Electrium-Mobility/RC-W25/README.md

# RC-W25
Electrium Mobility W25 Remote Control Project
