Electrium-Mobility/RC-W25/remote/RC-W25.kicad_pcb

## KiCad design remote/RC-W25.kicad_pcb (2025-04-18)

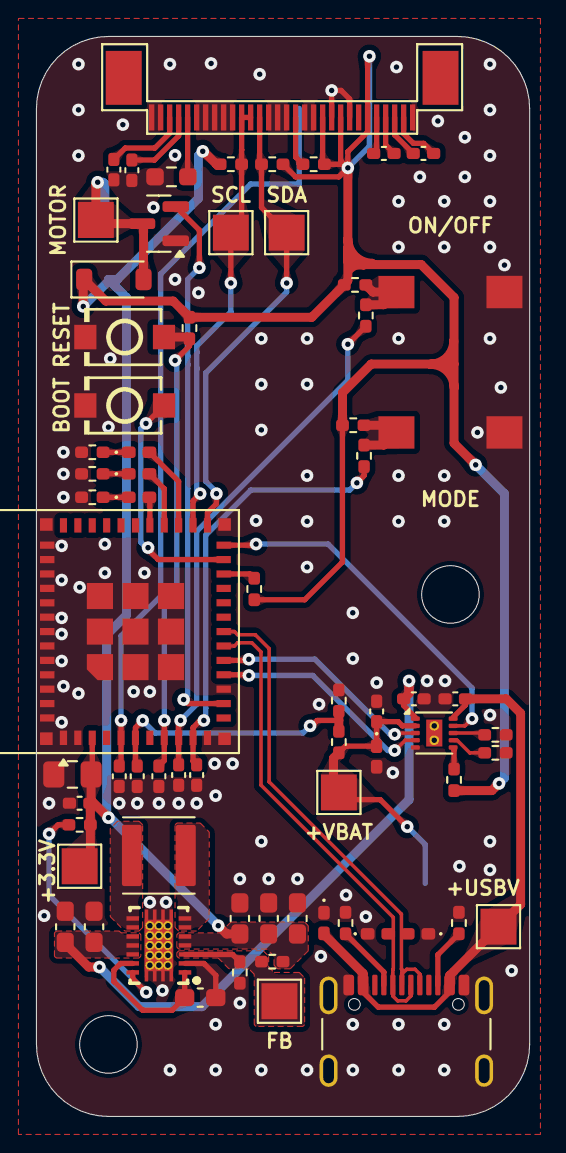
[picture p1: board RC-W25.kicad_pcb from above]

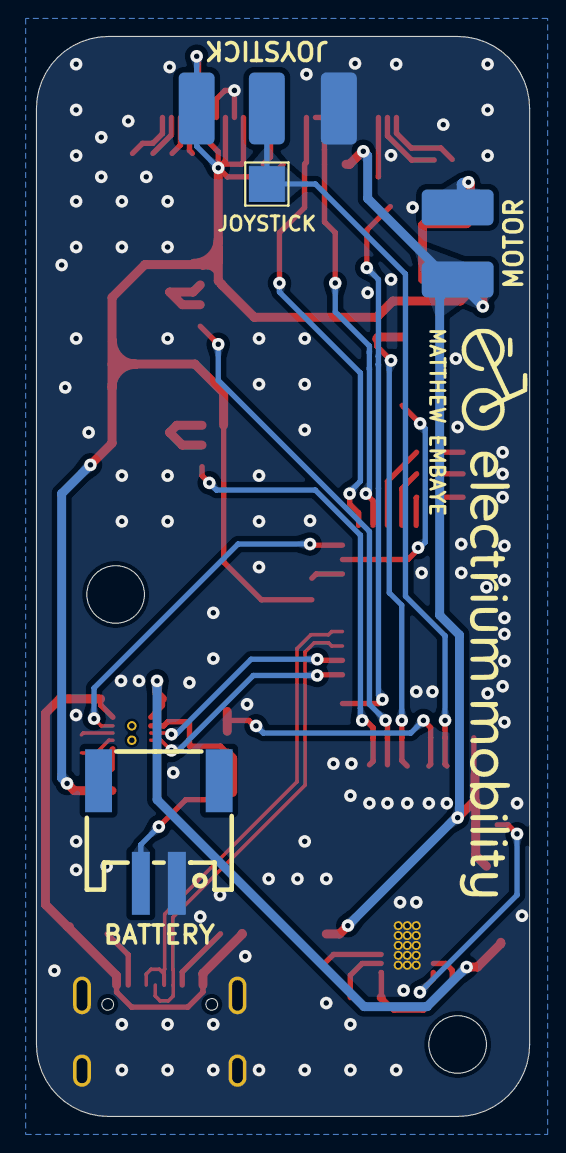
[picture p2: board RC-W25.kicad_pcb from below]

Board: 2 copper layers, 27.4 x 60.0 mm, 75 parts (4 on the bottom side), 47 nets.

Parts:
+3.3V: TEST POINT; TestPoint_Pad_2.0x2.0mm
+USBV: TEST POINT; TestPoint_Pad_2.0x2.0mm
+VBAT: TEST POINT; TestPoint_Pad_2.0x2.0mm
BATTERY: JST CONN; CONN-SMD_2P-P2.00_XUNPU_WAFER-PH2.0-2PWB
BOOT: Button; SW-SMD_L3.9-W3.0-P4.45
C1, C10: 4.7uF; C_0402_1005Metric_Pad0.74x0.62mm_HandSolder
C2, C18: 10uF; C_0402_1005Metric_Pad0.74x0.62mm_HandSolder
C3, C4: 2.2uF; C_0402_1005Metric_Pad0.74x0.62mm_HandSolder
C5, C6, C7, C9, C19, C20: 100nF; C_0402_1005Metric_Pad0.74x0.62mm_HandSolder
C8: 22uF; C_0805_2012Metric_Pad1.18x1.45mm_HandSolder
C11, C12: 10uF; C_0603_1608Metric_Pad1.08x0.95mm_HandSolder
C13: 100nF; C_0603_1608Metric_Pad1.08x0.95mm_HandSolder
C14: 1uF; C_0402_1005Metric_Pad0.74x0.62mm_HandSolder
C15, C16, C17: 22uF; C_0603_1608Metric_Pad1.08x0.95mm_HandSolder
D1, D2, D3: 6V TVS; D_0402_1005Metric_Pad0.77x0.64mm_HandSolder
D4: RLED; D_0402_1005Metric_Pad0.77x0.64mm_HandSolder
D5: ORLED; D_0402_1005Metric_Pad0.77x0.64mm_HandSolder
D6: GLED; D_0402_1005Metric_Pad0.77x0.64mm_HandSolder
D7: ZENER 5V; D_0402_1005Metric_Pad0.77x0.64mm_HandSolder
D8: D_Schottky; D_SOD-123
DS1: FPC 30P; FPC-30P-0.5mm
FB: TEST POINT; TestPoint_Pad_2.0x2.0mm
H1, H2: MountingHole; MountingHole_3.2mm_M3
J1: USB_C_Receptacle_USB2.0_14P; USB_C_Receptacle_GCT_USB4105-xx-A_16P_TopMnt_Horizontal
JOYSTICK: TEST POINT; TestPoint_Pad_2.0x2.0mm
JOYSTICK#2: JOYSTICK; Joystick Potentiometer Pads
L1: 1.5uH; L_Abracon_ASPI-4030S
MODE: Button; Box Tactile Button Switch
MOTOR: TEST POINT; TestPoint_Pad_2.0x2.0mm
MOTOR#2: MOTOR; Motor Pads
ON/OFF: Button; Box Tactile Button Switch
Q1: NMOS; SOT-23
R1: 390k; R_0603_1608Metric_Pad0.98x0.95mm_HandSolder
R2, R3, R4: 4.7k; R_0402_1005Metric_Pad0.72x0.64mm_HandSolder
R5, R6: 5.1k; R_0402_1005Metric_Pad0.72x0.64mm_HandSolder
R7, R8, R20, R21, R22, R23: 10k; R_0402_1005Metric_Pad0.72x0.64mm_HandSolder
R9, R10, R11: 300; R_0402_1005Metric_Pad0.72x0.64mm_HandSolder
R12: 5k; R_0402_1005Metric_Pad0.72x0.64mm_HandSolder
R13, R14, R17: 1k; R_0402_1005Metric_Pad0.72x0.64mm_HandSolder
R15, R19: 1M; R_0402_1005Metric_Pad0.72x0.64mm_HandSolder
R16: 180k; R_0402_1005Metric_Pad0.72x0.64mm_HandSolder
R18: 3.7k; R_0402_1005Metric_Pad0.72x0.64mm_HandSolder
RESET: Button; SW-SMD_L3.9-W3.0-P4.45
SCL: TEST POINT; TestPoint_Pad_2.0x2.0mm
SDA: TEST POINT; TestPoint_Pad_2.0x2.0mm
U1: ESP32-C6-MINI-1
U2: BQ25185; WSON-10 BQ25185
U3: TPS63020; TPS63020_VSON(14)

Connections:
+3.3V: +3.3V.1, C8.1, C9.1, C15.1, C16.1, C17.1, D8.1 (K), DS1.6 (VPump), DS1.9 (VLogic), DS1.11 (BS1), JOYSTICK#2.1, MOTOR#2.2, R2.1, R3.1, R4.1, R7.1, R8.1, R14.1, R15.1, R19.1, R20.1, R21.1, U1.3 (3V3), U3.4 (VOUT), U3.5 (VOUT)
+USB5V: +USBV.1, C10.1, D2.2 (A2), J1.A4 (VBUS), J1.A9 (VBUS), J1.B4 (VBUS), J1.B9 (VBUS), U2.10 (IN)
+VBAT: +VBAT.1, BATTERY.2, C14.1, D7.1 (K), R17.1, U2.2 (BAT)
+VSYS: C11.1, C12.1, C18.1, U2.1 (SYS), U3.10 (VIN), U3.11 (VIN), U3.12 (EN)
/Connections/FLASH: BOOT.1, U1.23 (IO9)
/Connections/RESET: C7.1, R8.2, RESET.1, U1.8 (EN)
/Power/ILIM/VSET: R12.1, U2.7 (ILIM/VSET)
/Power/TS/MR: R14.2, U2.6 (TS/MR)
ADC_BATTERYPERCENT: C6.1, R17.2, R18.1, U1.6 (IO3)
ADC_JOYSTICK: C5.1, JOYSTICK.1, JOYSTICK#2.2, U1.5 (IO2)
CHSTAT1: U1.24 (IO18), U2.9 (STAT1)
CHSTAT2: U1.16 (IO7), U2.3 (STAT2)
CH_EN: U1.15 (IO6), U2.4 (CE)
GND: BATTERY.1, BOOT.2, C1.2, C2.2, C5.2, C6.2, C7.2, C8.2, C9.2, C10.2, C11.2, C12.2, C13.2, C14.2, C15.2, C16.2, C17.2, C18.2, C19.2, C20.2, D1.1 (A1), D2.1 (A1), D3.1 (A1), D7.2 (A), DS1.1 (GND), DS1.8 (GND), DS1.10 (BS0), DS1.12 (BS2), DS1.13 (C/S), DS1.15 (D/C), DS1.16 (R/W), DS1.17 (E/RD), DS1.21 (D3), DS1.22 (D4), DS1.23 (D5), DS1.24 (D6), DS1.25 (D7), DS1.29 (GND-A), DS1.30 (GND), J1.A1 (GND), J1.A12 (GND), J1.B1 (GND), J1.B12 (GND), J1.S1 (SHIELD), JOYSTICK#2.3, MODE.2, ON/OFF.2, Q1.1 (D), R1.2, R5.2, R6.2, R9.2, R10.2, R11.2, R12.2, R13.2, R16.2, R18.2, RESET.2, U1.1 (GND), U1.2 (GND), U1.11 (GND), U1.14 (GND), U1.36 (GND), U1.37 (GND), U1.38 (GND), U1.39 (GND), U1.40 (GND), U1.41 (GND), U1.42 (GND), U1.43 (GND), U1.44 (GND), U1.45 (GND), U1.46 (GND), U1.47 (GND), U1.48 (GND), U1.49 (GND), U1.50 (GND), U1.51 (GND), U1.52 (GND), U1.53 (GND), U2.5 (GND), U3.2 (GND), U3.15 (PGND)
GPIO_MODE: C19.1, R22.2, U1.10 (IO5)
GPIO_RUMBLE_CNTL: Q1.2 (G), U1.13 (IO1)
unnamed: D4.2 (A), U1.27 (IO21)
unnamed: D4.1 (K), R9.1
unnamed: D5.2 (A), U1.28 (IO22)
unnamed: D5.1 (K), R10.1
unnamed: D6.2 (A), U1.29 (IO23)
unnamed: D6.1 (K), R11.1
unnamed: D8.2 (A), MOTOR.1, MOTOR#2.1, Q1.3 (S)
unnamed: C4.2, DS1.5 (C1N)
unnamed: C4.1, DS1.4 (C1P)
unnamed: C3.2, DS1.3 (C2N)
unnamed: C3.1, DS1.2 (C2P)
unnamed: DS1.26 (IREF), R1.1
unnamed: DS1.14 (Reset), R3.2
unnamed: C1.1, DS1.27 (VCOMH)
unnamed: C2.1, DS1.28 (VDisplay)
unnamed: J1.A5 (CC1), R6.1
unnamed: J1.B5 (CC2), R5.1
unnamed: L1.1, U3.8 (L1), U3.9 (L1)
unnamed: L1.2, U3.6 (L2), U3.7 (L2)
unnamed: MODE.1, R20.2, R22.1
unnamed: ON/OFF.1, R21.2, R23.1
unnamed: R7.2, U1.22 (IO8)
unnamed: R13.1, U2.8 (ISET)
unnamed: FB.1, R15.2, R16.1, U3.3 (FB)
unnamed: R19.2, U3.14 (PG)
unnamed: C13.1, U3.1 (VINA), U3.13 (PS/SYNC)
ON/OFF: C20.1, R23.2, U1.9 (IO4)
SCL_DISPLAY: DS1.19 (D1), DS1.20 (D2), R4.2, SCL.1, U1.26 (IO20)
SDA_DISPLAY: DS1.18 (D0), R2.2, SDA.1, U1.25 (IO19)
USB_D+: D1.2 (A2), J1.A6 (D+), J1.B6 (D+), U1.18 (IO13)
USB_D-: D3.2 (A2), J1.A7 (D-), J1.B7 (D-), U1.17 (IO12)
