Electrium-Mobility/RC-W25/receiver/receiver/reciever.kicad_pcb

## KiCad design receiver/receiver/reciever.kicad_pcb (2025-03-02)

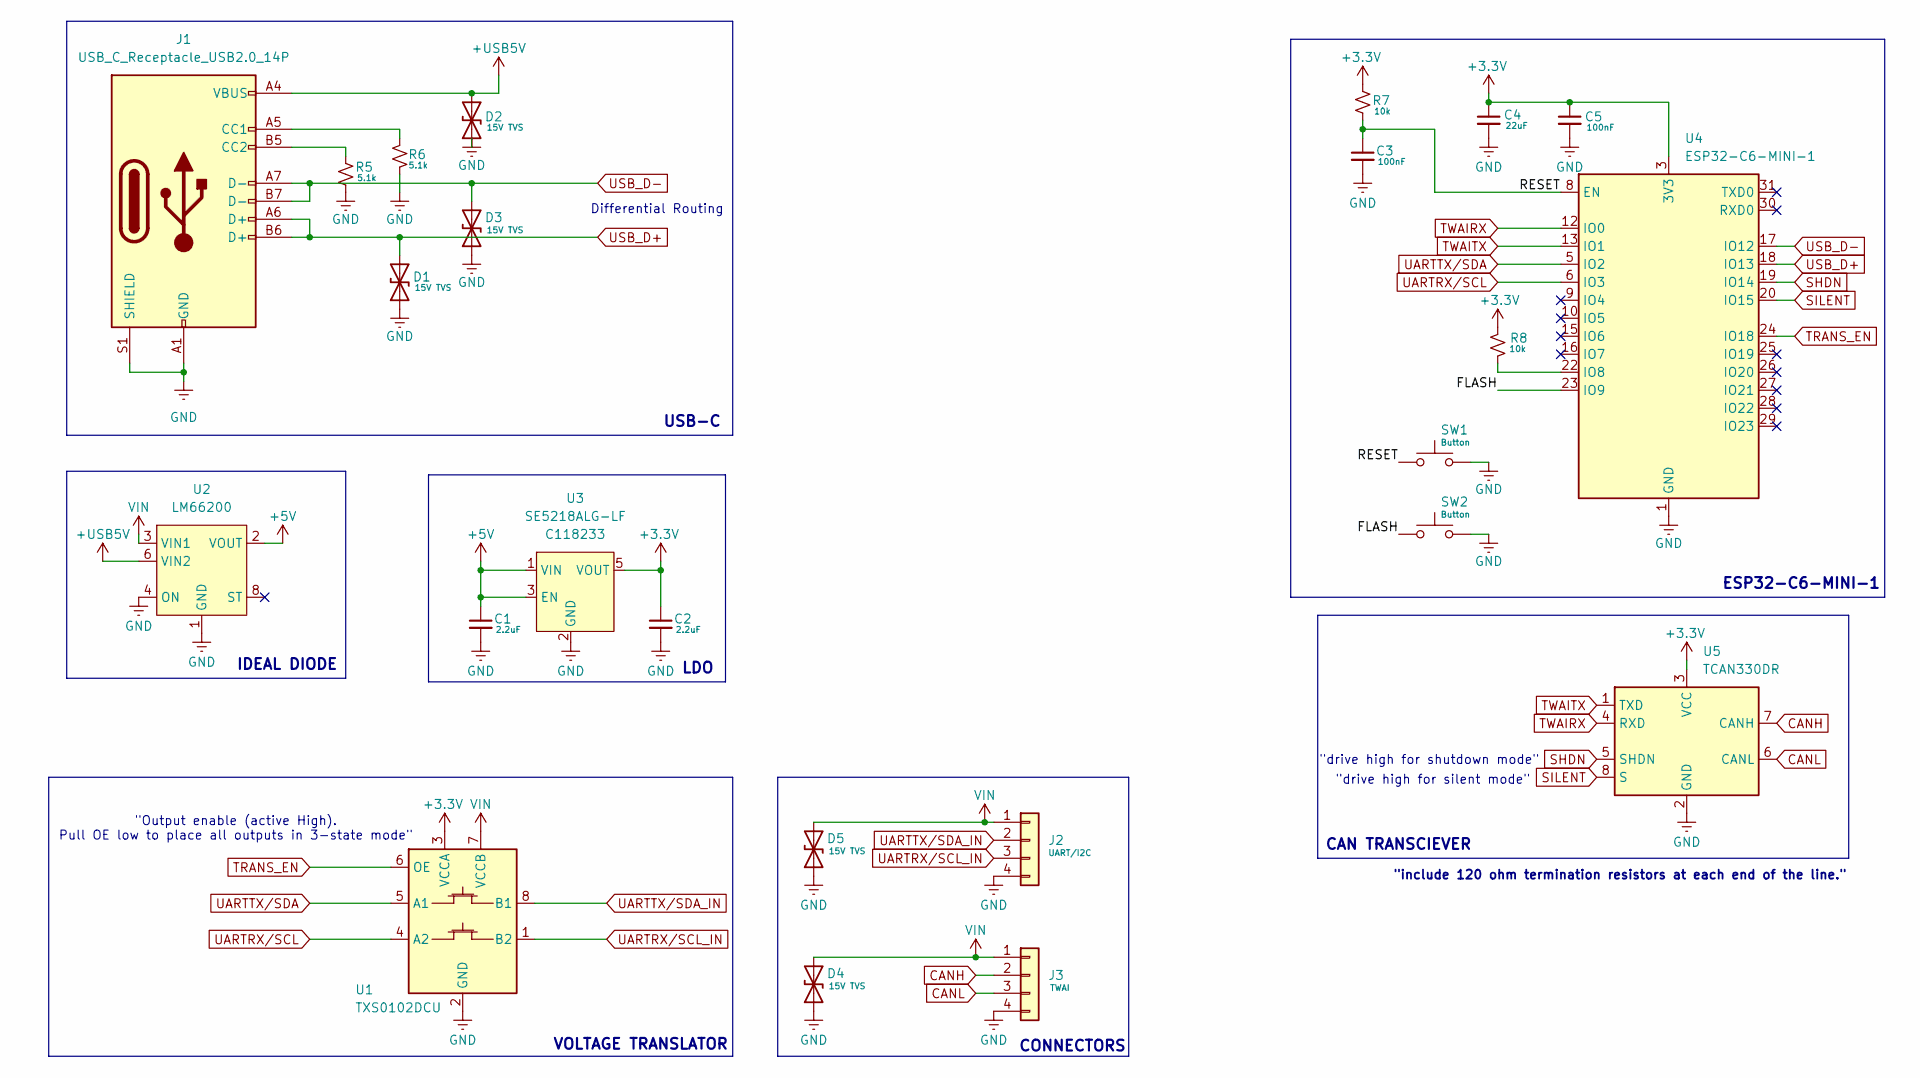
[picture p3: schematic reciever.kicad_sch]

Parts:
C1, C2: 2.2uF; C_0402_1005Metric; MPN C338067; LCSC# C338067
C3, C5: 100nF; C_0402_1005Metric; MPN C22435938; LCSC# C22435938
C4: 22uF; C_0805_2012Metric; MPN C380337; LCSC# C380337
D1, D2, D3, D4, D5: 15V TVS; D_0402_1005Metric; MPN C316043; LCSC# C316043
J1: USB_C_Receptacle_USB2.0_14P; USB_C_Receptacle_GCT_USB4105-xx-A_16P_TopMnt_Horizontal; MPN C165948; LCSC# C165948
J2: UART/I2C; CONN-SMD_PH2.0-4PWB; MPN C50137; LCSC# C50137
J3: TWAI; CONN-SMD_PH2.0-4PWB; MPN C50137; LCSC# C50137
R5, R6: 5.1k; R_0402_1005Metric; MPN C852861; LCSC# C852861
R7, R8: 10k; R_0402_1005Metric; MPN C190095; LCSC# C190095
SW1, SW2: Button; SW-SMD_L3.9-W3.0-P4.45; MPN C720477; LCSC# C720477
U1: TXS0102DCU; VSSOP-8_2.3x2mm_P0.5mm; MPN C53434; LCSC# C53434
U2: LM66200; SOT-583-8; MPN C3235556; LCSC# C3235556
U3: SE5218ALG-LF; SOT-23-5; MPN C118233; LCSC# C118233
U4: ESP32-C6-MINI-1; MPN C5736265; LCSC# C5736265
U5: TCAN330DR; SOIC-8-1EP_3.9x4.9mm_P1.27mm_EP2.29x3mm; MPN C2652876; LCSC# C2652876

Connections:
+3.3V: C2.1, C4.1, C5.1, R7.1, R8.1, U1.3 (VCCA), U3.5 (VOUT), U4.3 (3V3), U5.3 (VCC)
+5V: C1.1, U2.2 (VOUT), U2.7 (VOUT), U3.1 (VIN), U3.3 (EN)
+USB5V: D2.2 (A2), J1.A4 (VBUS), J1.A9 (VBUS), J1.B4 (VBUS), J1.B9 (VBUS), U2.6 (VIN2)
/FLASH: SW2.1, U4.23 (IO9); also elsewhere on the board
/RESET: C3.1, R7.2, SW1.1, U4.8 (EN); also elsewhere on the board
CANH: J3.2, U5.7 (CANH)
CANL: J3.3, U5.6 (CANL)
GND: C1.2, C2.2, C3.2, C4.2, C5.2, D1.1 (A1), D2.1 (A1), D3.1 (A1), D4.1 (A1), D5.1 (A1), J1.A1 (GND), J1.A12 (GND), J1.B1 (GND), J1.B12 (GND), J1.S1 (SHIELD), J2.4, J3.4, R5.2, R6.2, SW1.2, SW2.2, U1.2 (GND), U2.1 (GND), U2.4 (ON), U2.5 (GND), U3.2 (GND), U4.1 (GND), U4.2 (GND), U4.11 (GND), U4.14 (GND), U4.36 (GND), U4.37 (GND), U4.38 (GND), U4.39 (GND), U4.40 (GND), U4.41 (GND), U4.42 (GND), U4.43 (GND), U4.44 (GND), U4.45 (GND), U4.46 (GND), U4.47 (GND), U4.48 (GND), U4.49 (GND), U4.50 (GND), U4.51 (GND), U4.52 (GND), U4.53 (GND), U5.2 (GND); also elsewhere on the board
unnamed: J1.A5 (CC1), R6.1
unnamed: J1.B5 (CC2), R5.1
unnamed: R8.2, U4.22 (IO8)
SHDN: U4.19 (IO14), U5.5 (SHDN)
SILENT: U4.20 (IO15), U5.8 (S)
TRANS_EN: U1.6 (OE), U4.24 (IO18)
TWAIRX: U4.12 (IO0), U5.4 (RXD)
TWAITX: U4.13 (IO1), U5.1 (TXD)
UARTRX/SCL: U1.4 (A2), U4.6 (IO3)
UARTRX/SCL_IN: J2.3, U1.1 (B2)
UARTTX/SDA: U1.5 (A1), U4.5 (IO2)
UARTTX/SDA_IN: J2.2, U1.8 (B1)
USB_D+: D1.2 (A2), J1.A6 (D+), J1.B6 (D+), U4.18 (IO13)
USB_D-: D3.2 (A2), J1.A7 (D-), J1.B7 (D-), U4.17 (IO12)
VIN: D4.2 (A2), D5.2 (A2), J2.1, J3.1, U1.7 (VCCB), U2.3 (VIN1)

Notes on the sheet:
"drive high for silent mode"
"Output enable (active High). Pull OE low to place all outputs in 3-state mode"
USB-C
Differential Routing
"include 120 ohm termination resistors at each end of the line."
VOLTAGE TRANSLATOR
CONNECTORS
"drive high for shutdown mode"
ESP32-C6-MINI-1
IDEAL DIODE
LDO
CAN TRANSCIEVER

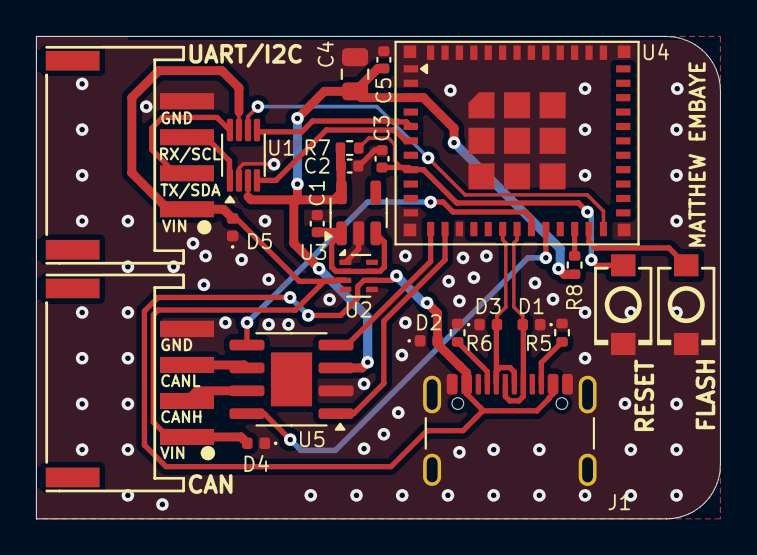
[picture p4: board reciever.kicad_pcb from above]

Board: 2 copper layers, 38.0 x 26.8 mm, 24 parts (0 on the bottom side), 23 nets.

Other parts of the board:
FLASH: Button; SW-SMD_L3.9-W3.0-P4.45
RESET: Button; SW-SMD_L3.9-W3.0-P4.45

Their connections:
/FLASH: FLASH.1; also elsewhere on the board
/RESET: RESET.1; also elsewhere on the board
GND: FLASH.2, RESET.2; also elsewhere on the board
