Electrium-Mobility/RC-W25/firmware/RC-Firmware/src/speed_control.h

#ifndef SPEED_CONTROL_H
#define SPEED_CONTROL_H

#include "driver/adc.h"
#include "init.h"

//Raw ADC readings for both sensors in the middle position
//Will tune this during integration they should be the same
#define SPEED_CONTROL_TAG "Speed Control"
#define ZERO_POSITION_VOLTAGE 1.65 //Taken from datasheet (VCC/2)

int get_rumble_control();
void get_safe_mode();
float get_throttle_speed(int mode_control, float speed_percent);

double read_adc_avg(adc1_channel_t channel, int num_samples);
void interpret_hall_readings();

#endif
