Electrium-Mobility/RC-W25/firmware/RC-Firmware/src/init.h

#ifndef INIT_H
#define INIT_H

#define HALL_EFFECT ADC1_CHANNEL_2
#define BATTERY_PERCENT ADC1_CHANNEL_3
#define SAFE_MODE ADC1_CHANNEL_4
#define HAPTIC_CNTL ADC1_CHANNEL_6
#define LED_PIN GPIO_NUM_2 // built-in

#define ZERO_POSITION 200.0 //Raw ADC value for zero position

#define INIT_TAG "Initialization"

extern double throttle;
extern bool safeMode;
extern int boardRpm;
extern int remoteBatteryLevel;
extern int boardBatteryLevel;

void init();
void initADC();
void initGPIO();
void initEspNow();

#endif
