Electrium-Mobility/RC-W25/(commit log)

2025-01-28 Schematic Update
    Completed connections schematic
    [RC-W25.kicad_pcb, RC-W25.kicad_sch, RC_Battery.kicad_sch, RC_Connections.kicad_sch]
2025-01-28 Schematic Update
    Added buttons with debouncing and DC motor duraclik connector
    [RC-W25.kicad_sch, RC_Battery.kicad_sch, RC_Connections.kicad_sch, RC_Motor&HallEffect.kicad_sch]
2025-01-28 Updated Schematic
    Introduced linear hall effect sensors
    [RC_Connections.kicad_sch, RC_Motor&HallEffect.kicad_sch]
2025-01-28 Configured platformio for esp32-c6
2025-02-05 Updated Battery
    [RC_Motor&HallEffect.kicad_sch]
2025-02-07 Updated Footprints
    [RC_Battery.kicad_sch, RC_Connections.kicad_sch, RC_Motor&HallEffect.kicad_sch]
2025-02-07 Almost Finalized Schematic
    Still need to spec out buttons and jst conn
    [RC_Battery.kicad_sch, RC_Connections.kicad_sch, RC_Motor&HallEffect.kicad_sch]
2025-02-09 Began Routing
    Only need to spec out buttons before completion
    [RC-W25.kicad_pcb, RC_Battery.kicad_sch, RC_Connections.kicad_sch, RC_Motor&HallEffect.kicad_sch]
2025-02-10 ESP32 pairing with ESP-NOW
2025-02-10 ESP32 pairing file fix
    [pairing.c]
2025-02-10 Created speed control file and header
    Includes hall effect, mode control and rumble control
2025-02-10 EM Custom RC V1
    [RC-W25.kicad_pcb, RC_Battery.kicad_sch, RC_Connections.kicad_sch, RC_Motor&HallEffect.kicad_sch]
2025-02-10 em crc v1
    remaining tasks:
    - clean up + verify
    - potentially try to lose the 3 via jumps
    - spec out jst connectors
    [RC-W25.kicad_pcb]
2025-02-10 crc v1
    finalized!! finally!! yes!!
    - spec out 3.7V 1000mAh cell
    - spec out ultra-thin coin motor
    ^make sure they have a jst-ph male connector or are organized to be ordered alongside one for manual soldering.
    [RC-W25.kicad_pcb, RC_Battery.kicad_sch, RC_Connections.kicad_sch, RC_Motor&HallEffect.kicad_sch]
2025-02-12 crc v1
    board complete and ready for assembly setup!
    [RC-W25.kicad_pcb, RC_Connections.kicad_sch, reciever.kicad_pcb, reciever.kicad_sch]
2025-02-12 crc v1
    board complete and ready for assembly setup
    [RC-W25.kicad_pcb, RC_Connections.kicad_sch]
2025-02-12 crc v1
    board finished and ready for assembly setup!
    [RC-W25.kicad_pcb, RC_Connections.kicad_sch, reciever.kicad_sch]
2025-02-12 crc v1
    quick fixes
    [RC-W25.kicad_pcb, RC_Battery.kicad_sch, RC_Connections.kicad_sch, RC_Motor&HallEffect.kicad_sch, reciever.kicad_sch]
2025-02-12 crc v2
    finalizing receiver layout
    [RC-W25.kicad_pcb, RC_Battery.kicad_sch, reciever.kicad_pcb, reciever.kicad_sch]
2025-02-13 crc v2
    main board and receiver finalized. ready for assembly!
    [RC-W25.kicad_pcb, reciever.kicad_pcb, reciever.kicad_sch]
2025-02-14 crc v2
    remote and receiver complete! assembly and orders have been prepared for purchasing.
    [RC-W25.kicad_pcb, RC_Battery.kicad_sch, RC_Connections.kicad_sch, RC_Motor&HallEffect.kicad_sch, bom.csv, designators.csv, positions.csv, reciever.kicad_pcb]
2025-02-19 Custom RC V2
    Final Remote + Receiver!
    Special thanks to the CRCW25 Electrical Team who contributed to its development!
    Jun
    Katie
    Nelson
    David
    [bom.csv, designators.csv, positions.csv, reciever.kicad_pcb, reciever.kicad_sch]
2025-03-13 added casing repo
    [RC-W25.kicad_pcb, RC-W25.kicad_sch, RC_Battery.kicad_sch, RC_Connections.kicad_sch, RC_Motor&HallEffect.kicad_sch, bom.csv, designators.csv, positions.csv]
2025-03-26 updated traces
    [RC-W25.kicad_pcb]
2025-04-03 CRC V3
    V 3.0.0
    Initial version of CRC V3, fully redesigned remote
    [RC-W25.kicad_pcb, RC-W25.kicad_sch, RC_Battery.kicad_sch, RC_Connections.kicad_sch, RC_Motor&HallEffect.kicad_sch]
2025-04-17 RCW25
    Finalized for order
    [RC-W25.kicad_pcb]
2025-04-18 Finalized design for review and order
    [RC-W25.kicad_pcb, RC_Battery.kicad_sch, RC_Connections.kicad_sch]
